z00mm00z/Rocket-Motor-Test-Stand/README.md

# Introduction: 
I built this project to get some experience actually completing a project for once. This repo should serve as a resource for people looking to build a motor test stand similar to this, as I found that this topic wasn't covered much online in detail.

# How it works:
The system does 3 main things: 
- Reads and Logs thrust data. 
- Manages the countdown and ignition of the motor, as well as the calibration of the loadcell. 
- Produces noises and light appropriate for the current situation.
  
Ignition and data recording is automated from the beginning of the countdown to the end of the burn. Data is logged in a CSV file and I've written a very simple "protocol" to read from a config file (where most settings can be adjusted), the format of which is borrowed from Joe Barnard.

The system also waits for a period of time after burnout to make sure that it has not incorrectly detected burnout and that we don't lose any data as a result.

## Example Data From Two Motor Firings:
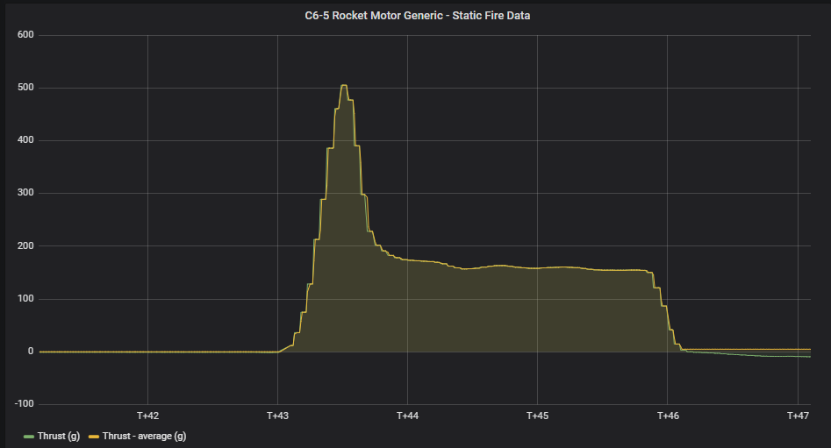
[picture p1: README_Images/C6-5_Static_Fire_Data_Img.png]
C6-5

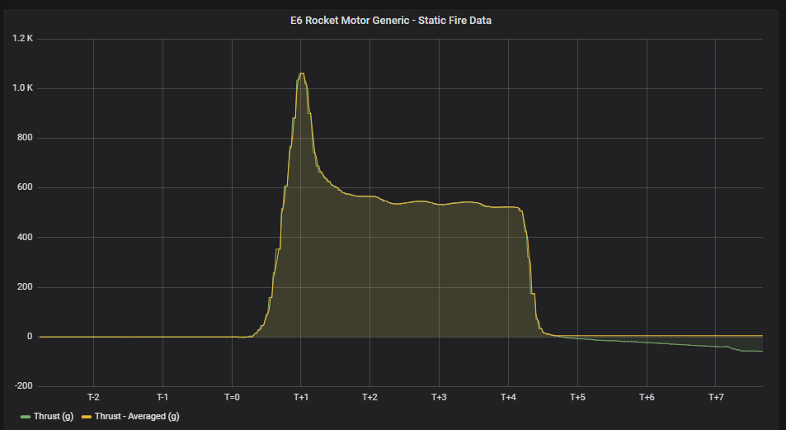
[picture p2: README_Images/E6_Static_Fire_Data_Img.png]
E6


## Loadcell Calibration: 
When you start up the system, you will be prompted to calibrate the Loadcell. The process produces a calibration value that is automatically saved to the config file and can be loaded instead of repeating the calibration process. Keep in mind that the loadcell is tared when loading the calibration value from the config file and the loadcell is very sensitive to temperature.  (tare - getting the zero offset)

## Dependencies
- Arduino SD Library
- HX711_ADC Library

## Some Additional Notes
- Using a 9V battery is not at all optimal for powering igniters. Use a proper battery.
- Having electronics solely in control of a countdown for a static fire or launch is not safe. It wasn't too much of an issue at this scale but you should be able to abort at any time and that is not an option with this system.
