z00mm00z/Rocket-Motor-Test-Stand/Hardware/Hardware Schematic/Hardware-Schematic.pdf

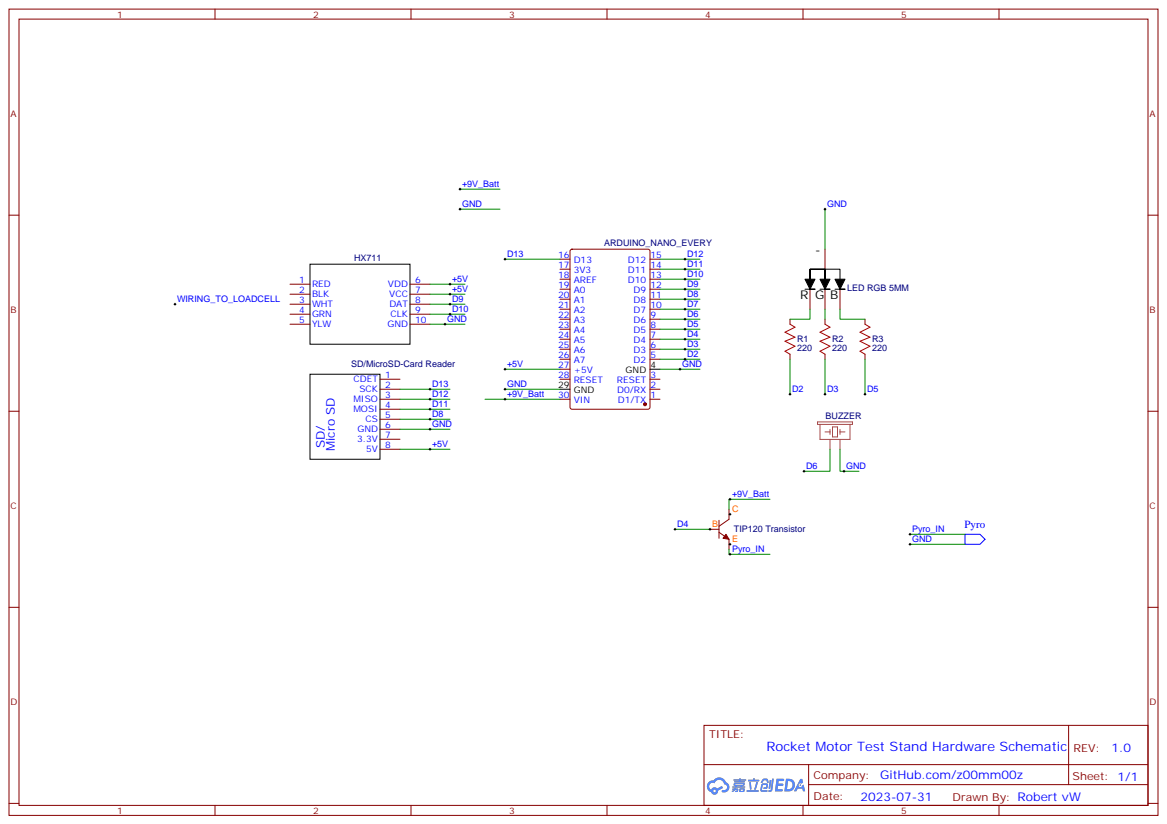
[picture p3: page 1]

Drawn By: Robert vW
