z00mm00z/Rocket-Motor-Test-Stand/(commit log)

2023-07-31 Data Integrity Improvements + msc Improvements
    - Added system state after burn that makes sure we don't accidentally stop recording data during a burn
    - Prevented a loop time of over a minute being recorded (First loop is calculated at the start of the countdown. The system no longer treats the whole startup and subsequent standby as one loop)
    - Added Buzzer Status and Data Save Length variables to config system
    [MTS_FIRM_V4.ino]
2023-07-31 Added SD files
    [config.txt]
2023-07-31 Added Hardware Schematic
2023-08-18 Update MTS_FIRM_V4.ino - Spelling Error 😳
    [MTS_FIRM_V4.ino]
2023-09-24 Critical Fixes (It somehow broke)
    [MTS_FIRM_V4.ino]
2023-09-25 Software: Prints Settings on Start
2023-09-29 Firmware: Fixed a variable type error that caused countdown to be skipped
    Happened with a live firing and thank god the igniter took a while to fire or it would have gone off right next to me. :anguished:
    [MTS_FIRM_V4.ino]
2024-02-16 Firmware Update - Way datafile naming is managed changed
    - New firmware version with VS Code and PlatformIO
    - We now track the test number in config and name the new datafile based on that. Prevents data overwrite and having to save data between tests.
    [config.txt]
2024-02-16 Directory Changes
    [config.txt]
